LivekH/Mast_control_and_monitor-master/docs/Резюме_работ_v2.md

# Резюме проделанной работы — Mast control v2

Дата актуализации: ноябрь 2025. База: **v1** (джойстики, одна активная ось, реле, ШИМ) без изменения «железной» логики; новое в v2 — **OLED**, **GUI**, **петля 4–20 mA**, **нуль по кнопке**.

## Прошивка

| Компонент | Содержание |
|---|---|
| Скетч | `mast_control_v2/mast_control_v2.ino` |
| Зеркало PIO | `src_V2/mast_control_v2.cpp` |
| Библиотеки | `lib_V2/` — Wire, INA219_WE, U8g2 |
| Сборка Proteus hex | `mast_control_v2.ino.hex` (~976 Hz); `mast_control_v2_PWM244hz.ino.hex` (~244 Hz) |

**Флаг:** `MAST_OLED_PROTEUS` — `1` в симуляции (SSD1306, I2C 100 kHz), `0` на стенде (SSD1309, 400 kHz).

## Давление и INA219

- Петля **4–20 mA** (ИВЭ-50 в разрыве), ток через INA219.
- Пороги: **OPEN** &lt; 3,5 mA, **SHORT** &gt; 20,2 mA, шкала **0…250 bar** от `loop_zero_mA` до 20 mA.
- Нуль по **D12** (удержание **3 с**) или в Proteus — **Virtual Terminal `Z`/`z`**.
- После tare: текущий ток = **0 bar**; ниже нуля на дисплее **не минус**, а **0** (и OPEN при сильном падении).
- Дисплей: усреднение, шаг **2 bar**, зона «малых» значений (`pressure_display_zero_band`).

## OLED GUI

- Давление **000…250 bar**, статусы **PRESSURE SENSOR OPEN/SHORT**, **I2C FAILED**, **ZERO SET** / **TARE FAIL**, **TARE…** при удержании.
- Нижняя строка: разделитель, **3 индикатора осей** (активная — точка + стрелка), **вертикальная шкала ШИМ** с подписями **100** / **0** (шрифт 6×10, центр над/под шкалой).
- Перерисовка по изменению данных (кэш `gui_last_*`).

## Proteus

- Проект: `lib_V2/proteus_V2/`, OLED **SSD1306**, INA219, Nano 16 MHz.
- Защита tare от дребезга D12: повтор только после **отпускания**, cooldown, снятие ZERO SET по таймеру.
- Рекомендация по петле в симуляции: RV **~5,2 kΩ** для плавных шагов тока (см. `proteus_V2/README.md`).

## Документация

| Файл | Назначение |
|---|---|
| `docs/План_версии_v2.md` | План, SSD1309 vs 1306, структура репо |
| `docs/Пины_Arduino_Nano_v2.md` | Распиновка Nano / ATmega328P |
| `README.md` | Обзор репозитория v1/v2 |

## ШИМ D11 (эксперимент CED252)

- Основная v2: **~976 Hz** на D11 (стандарт Arduino).
- Вариант **`mast_control_v2_PWM244hz`**: **~244 Hz** для сравнения с [Walvoil CED252](https://www.walvoil.com/allegati/catalogo/CED252_US.pdf) (**100–150–220 Hz**), без смены пина.
- Описание: `docs/ШИМ_D11_CED252.md`.

## Следующий шаг

- **`#define MAST_OLED_PROTEUS 0`**, прошивка через Arduino IDE / Nano.
- Сборка щита, ИВЭ-50, OLED 2,42″ SSD1309, кнопка **D12**, проверка реле и **D11** на макете.
- Перечень модулей (BOM) — ведётся отдельно.

## Кратко сравнение с v1

| | v1 | v2 |
|---|----|-----|
| Индикация | TM1637 | OLED U8g2 |
| Давление | INA219 + пороги | То же + GUI + нуль D12 |
| Джойстики / реле / D11 | Эталон | Как v1 |
