LivekH/Mast_control_and_monitor-master/docs/Руководство_пользователя_v2.md

# Руководство пользователя — пульт управления мачтой (версия 2)

**Прошивка:** `mast_control_v2`  
**Дисплей:** OLED 128×64, I2C (на приборе — модуль 2,42″)  
**Давление:** датчик по петле **4–20 mA** (ИВЭ-50), измерение тока модулем INA219  

HTML для печати/PDF: **`Руководство_пользователя_v2.html`** (эта же папка) — открыть в браузере, **Ctrl+P**.

Документ для **оператора**: как читать экран и выполнять типовые действия. Технические детали монтажа — в `docs/Пины_Arduino_Nano_v2.md`, описание логики джойстиков (как в v1) — в `docs/Описание_системы_управления.md`.

---

## 1. Назначение

Пульт предназначен для:

- **подъёма и спуска** первой и второй секций мачты (два джойстика);
- **выдвижения и задвижения** «пальцев» (третий джойстик);
- **пропорционального** управления гидравлическим клапаном (мощность по отклонению ручки);
- **индикации давления** в гидросистеме (шкала **0…250 bar**);
- **установки рабочего нуля** датчика давления кнопкой на панели.

Одновременно **активна только одна ось**. Остальные джойстики не управляют клапанами, пока первая не возвращена в **нейтраль** (см. раздел 4).

---

## 2. Меры безопасности

1. Перед работой убедитесь, что **аварийная кнопка «СТОП»** (если установлена на вашей схеме) разрешает питание пульта и МК.
2. **Нейтраль по безопасности** — только когда **разомкнут концевик** на рукоятке джойстика. Положение ручки «примерно по центру» **без** нажатого концевика **не считается** нейтралью.
3. Не удерживайте кнопку **нуль давления** случайно: для срабатывания нужно **намеренное удержание 3 с**.
4. При надписях **OPEN**, **SHORT**, **I2C FAILED** не полагайтесь на цифры давления — устраните неисправность или обратитесь к обслуживающему персоналу.

---

## 3. Включение и заставка

После подачи питания на OLED кратковременно по очереди отображаются:

| Строка 1 | Строка 2 | Смысл |
|---|---|---|
| PRESSURE SENSOR | OPEN | Тест индикации (не означает аварию) |
| PRESSURE SENSOR | SHORT | Тест индикации |
| READY | v2 | Прибор готов к работе |

Затем открывается **основной экран** (раздел 5).

---

## 4. Управление джойстиками (кратко)

У **каждого** джойстика:

| Элемент | Назначение |
|---|---|
| **Концевик нейтрали** | Разомкнут → ось отключена. Замкнут (нажатие рукоятки) → ось может работать. |
| **Потенциометр (ручка)** | Направление и сила: сначала выбирается **реле** (направление), затем при большем отклонении — **ШИМ** пропорционального клапана. |

**Оси:**

| Джойстик | Функция | Реле (направление) |
|---|---|---|
| **1** | Секция мачты **1** | Подъём / спуск |
| **2** | Секция мачты **2** | Подъём / спуск |
| **3** | **«Пальцы»** | Закрыть / открыть |

**Типовая последовательность:**

1. Вернуть используемый джойстик в **нейтраль** (концевик **разомкнут**).
2. Нажать/отклонить рукоятку — концевик **замкнётся**, ось станет **активной** (на дисплее — заполненный кружок, см. §5).
3. Отклонить в нужную сторону: **вверх/закрыть** (стрелка вверх) или **вниз/открыть** (стрелка вниз).
4. По окончании операции — снова **нейтраль** (разомкнуть концевик).

**Смена направления** (вверх ↔ вниз) возможна только после **полного** возврата в нейтраль по концевику.

Подробные пороги АЦП, задержки и блокировка осей — в `docs/Описание_системы_управления.md` (логика совпадает с v1).

---

## 5. Главный экран (GUI)

Экран условно делится на **верх** (давление / сообщения) и **низ** (ось и ШИМ). Нижняя часть рисуется **всегда**, кроме кратких сервисных надписей по центру.

```
┌────────────────────────────────────────┐
│        012 bar          │ 100          │  ← давление или текст ошибки
│                         │ ┃            │     справа — шкала ШИМ
├─────────────────────────┤ ┃            │
│    ○      ○      ●↑     │ ┃▓▓          │  ← три оси: пальцы, мачта2, мачта1
└────────────────────────────────────────┘
                                    0
```

### 5.1. Индикация давления (норма)

- Крупные цифры **000…250** и подпись **bar**.
- Обновление с **шагом 2 bar** (на дисплее 0, 2, 4, …).
- Малые значения после нуля могут отображаться как **000** (зона подавления дрожи у нуля) — это нормально при стабильном низком давлении.
- Шкала привязана к петле **4–20 mA**: по умолчанию **4 mA ≈ 0 bar**, **20 mA ≈ 250 bar**, после **установки нуля** (§6) — от **текущего тока в момент tare**.

**Важно:** если ток в петле **опустится ниже** точки, которую вы зафиксировали как ноль, на дисплее показывается **0 bar**, а **не отрицательное** давление. Сильное падение тока — см. **OPEN** в §7.

### 5.2. Три кружка (слева направо на экране)

| Позиция на экране | Ось | Пульт |
|---|-----|---|
| **Слева** | «Пальцы» (3) | Джойстик 3 |
| **Центр** | Мачта 2 | Джойстик 2 |
| **Справа** | Мачта 1 | Джойстик 1 |

| Вид | Значение |
|-----|---|
| Пустой круг ○ | Ось не активна |
| Залитый круг ● | Ось **активна** |
| Стрелка **вверх** над/под кругом | Движение **вверх** / **закрыть** |
| Стрелка **вниз** | Движение **вниз** / **открыть** |

### 5.3. Шкала справа (ШИМ)

- Вертикальная полоса: снизу **0**, сверху **100** — **относительная мощность** пропорционального клапана для **активной** оси (0…100 %).
- Заполнение растёт при большем отклонении ручки **после** срабатывания направления реле.
- Если ни одна ось не активна — шкала **пустая** (0).

На железе для **пропорционального клапана** может быть залита основная прошивка (~976 Hz ШИМ на D11) или экспериментальная **~244 Hz** — см. `docs/ШИМ_D11_CED252.md`. На поведение джойстика и шкалы ШИМ на OLED это не влияет.

### 5.4. Горизонтальная линия

Разделитель между зоной давления/сообщений и индикаторами осей.

---

## 6. Кнопка «нуль давления» (ZERO)

**Расположение:** пин **D12** на контроллере, на панели — кнопка **«нуль» / «tare»** (замыкание на **GND** при нажатии).

**Назначение:** запомнить **текущий ток** в петле 4–20 mA как **0 bar** на дисплее (калибровка под условия монтажа, без записи в постоянную память — после перезагрузки опора снова **4 mA**, пока не выполните tare снова).

**Действия оператора:**

1. Установите в гидросистеме (или на ИВЭ) давление/ток, которое должно читаться как **0 bar**.
2. Нажмите и **удерживайте** кнопку **не менее 3 с**.
3. На экране появится **TARE…** (идёт удержание), затем **ZERO SET** (~1,2 с).
4. Отпустите кнопку. Должны отобразиться **000 bar** при **неизменном** токе.
5. Повторный сброс — после **отпускания** кнопки и паузы (защита от случайного двойного срабатывания).

| Сообщение | Значение |
|---|---|
| **TARE…** | Кнопка нажата, идёт отсчёт удержания |
| **ZERO SET** | Ноль принят успешно |
| **TARE FAIL** | Не выполнены условия (см. ниже) |

**TARE FAIL** возможен, если:

- нет связи с модулем тока (см. **I2C FAILED**);
- **OPEN** или **SHORT** по петле;
- ток вне допустимого диапазона для захвата нуля (примерно **3,6…19 mA**).

---

## 7. Сообщения об ошибках (верх экрана)

При ошибках **цифры давления скрываются**; нижняя полоса с осями и ШИМ **остаётся**.

| Экран | Причина (для оператора) |
|---|---|
| **PRESSURE SENSOR** / **OPEN** | Слишком малый ток в петле (обрыв, нет сигнала, глубокий провал ниже нормы 4–20 mA). |
| **PRESSURE SENSOR** / **SHORT** | Слишком большой ток (перегруз, КЗ в цепи датчика). |
| **I2C** / **FAILED** | Нет обмена с датчиком тока или дисплеем по шине I2C (проводка, питание модулей). |

**Действия:** прекратить опору на показания давления, проверить подключение ИВЭ-50 и модулей, вызвать специалиста. После восстановления сигнала экран вернётся к **000…250 bar** автоматически.

---

## 8. Типовые ситуации

| Ситуация | Что видно | Что делать |
|---|---|---|
| Старт после включения | READY v2 → главный экран | Работать по §4 |
| Давление растёт | Цифры растут с шагом 2 bar | Норма |
| После ZERO SET | 000 bar при том же режиме | Норма; дальше давление относительно **новой** нулевой точки |
| Другой джойстик «не реагирует» | Его кружок пустой | Сначала нейтраль **активной** оси |
| ШИМ не растёт | Стрелка есть, шкала низкая | Увеличить отклонение ручки (ШИМ включается **после** порога реле) |

---

## 9. Связанные документы

| Документ | Содержание |
|---|---|
| `docs/Пины_Arduino_Nano_v2.md` | Подключение выводов |
| `docs/Резюме_работ_v2.md` | Отличия v2 от v1, техническое резюме |
| `docs/План_версии_v2.md` | План развития |
| `docs/Описание_системы_управления.md` | Подробная логика джойстиков (v1, актуальна для v2) |
| `docs/ШИМ_D11_CED252.md` | Частота ШИМ на клапан (D11), вариант ~244 Hz |

**Перечень аппаратных модулей (BOM)** — по отдельному списку изготовителя прибора.

---

*Версия руководства соответствует прошивке mast_control_v2 (OLED GUI, нуль D12 3 с, шаг давления 2 bar).*
