LivekH/Mast_control_and_monitor-master/docs/ШИМ_D11_CED252.md

# ШИМ на D11 и ориентир Walvoil CED252

Документ для **настройщика и разработчика**. Оператору достаточно знать, что на пульте есть **основная** и **экспериментальная** прошивка — см. `README.md`.

## Источник: паспорт CED252

Официальный каталог (EN/US):

**[Walvoil CED252 — electronic control unit (US PDF)](https://www.walvoil.com/allegati/catalogo/CED252_US.pdf)**

Актуальные копии также на сайте Walvoil: [CED252](https://www.walvoil.it/prodotti/centraline-elettroniche/ced252) (ITA/ENG PDF).

### Что указано в документе (Proportional outputs)

| Параметр | CED252 (по каталогу) |
|---|---|
| Количество | **5** пропорциональных выходов |
| Тип | **HSD PWM** (*High Side Driver*) |
| **Частота ШИМ** | **100–150–220 Hz** (выбираемые/указанные режимы в паспорте) |
| Нагрузка | **до 2 A** на пропорциональный выход |
| Питание блока | **9…16 V** DC |
| ON/OFF выходы | 5 × HSD, до **5 A** |

Отдельно: разъём **Deutsch DRC23-40PA**, IP67, RS232 **9600 8N1**, CAN — это **готовая промышленная централь**, а не Arduino.

### Сравнение с нашим пультом (архитектурно)

| | CED252 | Наш Mast control (Nano) |
|---|---|---|
| Пропорциональный канал | 5 × HSD **12 V**, PWM **100/150/220 Hz** | 1 общий **ШИМ D11** (~976 Hz или ~244 Hz в варианте PWM244) |
| Направление / секции | Несколько силовых выходов HSD | **Реле D2–D7** (низкая сторона / по схеме щита) |
| Аналог «джойстика» | До 11 analog in, 0…5 V / 0…12 V | **A0–A2**, АЦП 0…5 V |
| Разводка | Deutsch 40 pin | Собственная PCB, **D11** на MOSFET |

Полная копия **аппаратуры** CED252 **без переразводки** невозможна: у Walvoil фиксированные **пины OUT_1…OUT_10** на разъёме, у нас — **D11** и реле. Перенос ШИМ на **D9** (Timer1) потребовал бы переделки платы и схемы ключа.

## Зачем вариант ~244 Hz

В каталоге верхняя указанная частота — **220 Hz**. На Nano **Timer2** (пин **D11**) при Fast PWM и **16 MHz** стандартные делители дают:

| Делитель Timer2 | f_pwm (типично) |
|---|---|
| /64 (Arduino по умолчанию) | **~976 Hz** |
| /256 (прошивка `*_PWM244hz`) | **~244 Hz** |

Точные **100 / 150 / 220 Hz** на D11 без смены таймера/режима **не попадают в таблицу делителей** Timer2 (шаг грубый). **244 Hz** — ближайший практический вариант **чуть выше 220 Hz** для полевого эксперимента «ближе к Walvoil, чем 976 Hz».

Формула (Fast PWM, 8 бит):

```text
f_pwm ≈ F_CPU / (N_prescaler × 256)    ; F_CPU = 16 MHz
```

Проверка: **осциллограф** на **D11** (затвор MOSFET / вход клапана по вашей схеме).

## Наши прошивки

| Скетч | ШИМ на D11 |
|---|---|
| `mast_control_v1` / `mast_control_v2` | **~976 Hz** (`analogWrite`) |
| `mast_control_v1_PWM244hz` / `mast_control_v2_PWM244hz` | **~244 Hz** (`analogWriteOutputPowerPwm244`) |

Логика джойстиков, реле, давление, дисплей — **как в основной** v1/v2; меняется только формирование ШИМ на пропорциональный клапан.

### Реализация PWM244 (AVR)

- **D11** = Timer2, **OC2A**.
- После каждого `analogWrite(11, …)` ядро Arduino снова ставит делитель **/64** → в коде сразу вызывается `timer2PwmPrescaler256()`.
- **D3** на том же Timer2 используется как **цифровое реле** — на частоту D11 не влияет.

## Какую прошивку выбрать

| Ситуация | Скетч |
|---|---|
| Макет, Proteus, «как было» | `mast_control_v1` / `v2` |
| Испытание клапана ближе к **100–220 Hz** по духу CED252 | `*_PWM244hz` |
| Итог после стенда | Зафиксировать в паспорте прибора и BOM |

На **~976 Hz** многие клапаны на макете **работают**; вопрос — комфорт, нагрев, динамика. Ориентир Walvoil — **HSD + низкая частота**; наш ключ может быть **low-side 5 V/12 V** — см. вашу схему силового ключа.

## Прошивка

- **v1 PWM244:** `mast_control_v1_PWM244hz/`, библиотеки `lib_V1/`.
- **v2 PWM244:** `mast_control_v2_PWM244hz/`, `lib_V2/`, на железе `MAST_OLED_PROTEUS 0`.

См. также README в папках `*_PWM244hz`, `docs/Пины_Arduino_Nano_v2.md` (D11).
