LivekH/Mast_control_and_monitor-master/docs/Описание_системы_управления.md

# Система управления и мониторинга

**Версия документа:** по прошивке `mast_control_v1/mast_control_v1.ino`  
**Назначение:** управление электромагнитными клапанами мачты и «пальцев» с пульта оператора, индикация давления по петле 4–20 mA, блокировка одновременной работы осей.

Документ можно открыть в браузере (HTML-версия в этой же папке) или в редакторе текста. Схему подключения добавьте отдельным листом.

**Состав основной платы:** плата микроконтроллера, релейный блок, модуль считывания тока (петля 4–20 mA), семисегментный цифровой дисплей (4 разряда).

---

## 1. Общий принцип работы

1. **Пульт оператора** (3 джойстика, нейтральные концевики, питание 5 V) подключается к **основной плате** разъёмом **LD20, 9 pin, male/female** (провода **0,2 mm²**). Внутри пульта и на плате микроконтроллера сигналы джойстиков и МК разведены **разъёмами Dupont**.
2. МК опрашивает **концевики нейтрали** и **аналоговые входы**. **Активна ровно одна ось**, защёлкнутая до её нейтрали; остальные не участвуют в управлении (1 — мачта 1, 2 — мачта 2, 3 — «пальцы»).
3. По выбранной оси МК **замыкает одно из двух реле** направления (подъём/спуск или открыть/закрыть). Направление реле **фиксируется до возврата джойстика в нейтраль по концевику** (рычаг в центре недостаточен — нужен разомкнутый концевик нейтрали).
4. **Пропорциональный канал:** с пина ШИМ (D11) на электромагнитный клапан подаётся сигнал **PWM 0–255** в зависимости от отклонения ручки (после порогов и сглаживания АЦП). Один общий ШИМ на все оси — одновременно работает только активная ось.
5. **Давление:** преобразователь 4–20 mA → **модуль считывания тока** (шина I2C) → расчёт величины на **семисегментный цифровой дисплей**.
6. **Питание пульта:** 12 V → модуль **DC/DC 12/5 V** → линия **+5 V** через **аварийную кнопку «СТОП»** на питание платы микроконтроллера (5 V) и разводку **+5 V / GND** для джойстиков в пульте.

На полевые выходы (клапаны, +12 V, петля 4–20 mA, ШИМ) выведен разъём **LD20, 12 pin, male/female** (провода **0,35 mm²**).

---

## 2. Работа одного джойстика (пример — ось 1, мачта 1)

**Джойстики 2 и 3** подключены и обрабатываются **так же**: тот же концевик нейтрали, те же пороги АЦП, защёлка реле, общий ШИМ и правило «одна активная ось». Отличаются только пины (A1/A2, D9/D10), пары реле (мачта 2 — D4/D5, «пальцы» — D6/D7) и подписи «вверх/вниз» или «закрыть/открыть».

У **одного джойстика** два независимых канала в логику МК:

| Канал | Назначение | Поведение |
|---|---|---|
| **Концевик нейтрали** (кнопка на рукоятке) | Разрешение движения по этой оси | В нейтрали контакт **разомкнут** — ось «спит». При работе контакт **замкнут на GND** — ось может управлять клапанами (если не заблокирована другой активной осью). |
| **Потенциометр** (A0 для оси 1) | Направление и сила (реле + ШИМ) | Выдаёт напряжение, пропорциональное отклонению ручки; МК переводит его в число АЦП (0…1023). |

Ниже — пошагово, что делает прошивка **каждый цикл**, если оператор работает **только джойстиком 1** (остальные в нейтрали).

### 2.1. Состояние «в нейтрали»

1. Концевик разомкнут → на входе D8 логическая **«1»** (подтяжка к +5 V).
2. Флаг **нейтрали оси 1** истинен: **реле мачты 1 не включаются**, **ШИМ = 0**, **защёлка направления сброшена** (можно снова выбрать «вверх» или «вниз»).
3. Потенциометр в этот момент **не определяет** выходы: даже если ручка стоит сбоку, без замкнутого концевика клапаны по оси 1 **не получают команд**.

Это сделано специально: **центр по рукоятке ≠ нейтраль по безопасности** — нейтраль подтверждается только концевиком.

### 2.2. Выход из нейтрали и выбор активной оси

1. Оператор нажимает/отклоняет рукоятку → концевик **замыкается** → на D8 **«0»** (после подавления дребезга ~25 ms).
2. Ось 1 перестаёт быть нейтральной — **фиксируется как активная** до возврата концевика в нейтраль; оси 2 и 3 в этот момент не влияют на выходы даже при случайном нажатии.
3. МК начинает **читать A0**: 4 замера подряд, усреднение, лёгкое сглаживание (фильтр ¾ старое + ¼ новое) — чтобы убрать дрожь проводов.

Пока другой джойстик уже **защёлкан как активный** (например, работает ось 2), ось 1 **не перехватит** управление — её АЦП не обрабатывается, пока ось 2 не вернётся в нейтраль.

### 2.3. Выбор направления реле (защёлка)

Центр шкалы АЦП для всех осей: **510** (нейтраль потенциометра в коде).

| Зона АЦП (ось 1, мачта) | Действие реле |
|---|---|
| **≥ 540** (center + 30) | Защёлка «**вверх**» → реле **D2** (вверх) |
| **≤ 480** (center − 30) | Защёлка «**вниз**» → реле **D3** (вниз) |
| **481…539** | Направление ещё **не выбрано** (мёртвая зона у центра) |

**Важно:** направление реле выбирается **один раз** за один «ход» из нейтрали. Если оператор потянул вверх и защёлка сработала, при откате ручки к центру реле **не переключится** на «вниз» — остаётся «вверх», пока не вернёт **нейтраль концевиком**.

Чтобы **сменить направление** (вверх ↔ вниз): вернуть рукоятку в нейтраль (концевик **разомкнут**), дождаться сброса защёлки, снова выйти из нейтрали и отклонить в другую сторону.

### 2.4. Реле уже есть — включение пропорционального ШИМ

Пороги **ШИМ шире**, чем у реле (чтобы сначала встало направление, потом подросла мощность):

| Направление (защёлка) | Порог старта ШИМ | Шкала |
|---|---|---|
| Вверх | АЦП **≥ 570** | От **570** до упора **758** → ШИМ **51…255** (~20…100 %) |
| Вниз | АЦП **≤ 450** | От **450** до упора **250** → ШИМ **51…255** |

Между порогом реле и порогом ШИМ есть **зазор**: сначала замыкается реле направления (+12 V на нужный соленоид через релейный блок), затем при большем отклонении ручки на общий пропорциональный клапан идёт **ШИМ с D11**.

Если изменение ШИМ меньше **5** единиц — прошивка **не дёргает** выход (deadband), чтобы клапан не «пел».

### 2.5. Что уходит на поле (один цикл выдачи)

Перед каждой выдачей МК **кратко гасит все реле и ШИМ**, затем включает **только активную ось**:

1. **Реле:** одно из двух (вверх D2 или вниз D3) — активный уровень **LOW** (реле замкнуто).
2. **ШИМ:** значение **axis_1_out** на силовой ключ (вывод **D11**, на разъёме LD20 12 pin — **PWM com** по вашей силовой схеме).
3. На выходном разъёме соответственно загораются линии **Valve 1 up** или **Valve 1 down** и общий **+12 V**.

Оси 2 и 3 в этот момент **заблокированы** — их реле и ШИМ не управляются, даже если кто-то случайно задел другую рукоятку.

### 2.6. Возврат в нейтраль

1. Оператор отпускает рукоятку → концевик **размыкается** → снова D8 = «1».
2. Сбрасываются: **защёлка реле**, фильтры АЦП и накопленный ШИМ для оси 1.
3. В цикле **stopAllMotionOutputs** все реле и ШИМ отключены → клапан мачты 1 без питания направления и без пропорциональной составляющей.

После этого можно выбрать **другую ось** (джойстик 2 или 3) — алгоритм тот же.

### 2.7. Краткая «шпаргалка» оператора (ось 1)

```text
Нейтраль (концевик разомкнут)     → всё стоит
Вышел из нейтрали + «вверх»/«вниз» → защёлкнулось реле направления
Дотянул ручку дальше              → растёт ШИМ (плавнее/сильнее)
Вернул концевик в нейтраль        → стоп, сброс; можно другую ось или другое направление
```

---

## 3. Блокировки и защита оператора

| Механизм | Описание |
|---|---|
| **Одна активная ось** | **Защёлка:** как только ось вышла из нейтрали, она остаётся единственной активной до возврата концевика в нейтраль; остальные **не читаются и не управляют** (`lock_*` в отладке). Работа ось 1 → блок 2 и 3; ось 2 → блок 1 и 3; ось 3 → блок 1 и 2. Если все в нейтрали и сразу нажаты несколько джойстиков — выбор 1 → 2 → 3 (только в момент «старта»). |
| **Нейтраль концевика** | В нейтрали концевик **разомкнут** (на МК `INPUT_PULLUP`, лог. 1). При работе концевик **замкнут на GND** (лог. 0). Пока все в нейтрали — реле и ШИМ не активируются. |
| **Защёлка направления реле** | После выхода из нейтрали направление (вверх/вниз, открыть/закрыть) выбирается по АЦП один раз; реле **не переключается** при колебании ручки около центра, пока оператор не вернёт ось в **нейтраль концевиком**. |
| **Реле / ШИМ по порогам** | Универсальный профиль: center **510**; реле **≤480 / ≥540** АЦП; ШИМ **≤450 / ≥570** АЦП; сглаживание АЦП (4 выборки + фильтр) и deadband ШИМ **±5**. |
| **Аварийный стоп (аппаратный)** | Разрыв **+5 V** на МК и пульт до кнопки СТОП — при нажатии питание контроллера и джойстиков отключается (описывается монтажом, не прошивкой). |
| **Петля 4–20 mA** | Ниже **3,5 mA** — режим обрыва **`-OC-`**. Выше **20,2 mA** — **`-SC-`**. У нуля шкалы ток **&lt; 4,15 mA** считается **0** на индикаторе (шум измерения). |
| **I2C / модуль тока** | Таймаут шины, восстановление; при длительном сбое (**5 с**) — **`I2c-`** на дисплее. |
| **Реле** | Активный уровень **LOW** (реле замкнуто). Перед каждым циклом выходов — кратковременное **отключение всех реле и ШИМ**, затем включение только активной оси (исключение коротких сквозных состояний). |

---

## 4. Пульт оператора — разъём LD20 9 pin (0,2 mm²)

Связь пульт ↔ основная плата: **LD20, 9 контактов, male/female**. Подключение джойстиков и выводов на **плату микроконтроллера** внутри узла — **Dupont**.

| № пина | Назначение | Цвет провода | Подключение на плате МК |
|---|---|---|---|
| 1 | **VCC +5 V in** (после СТОП) | Красный | +5 V платы микроконтроллера (питание МК и логики) |
| 2 | **+5 V out** (на джойстики пульта) | Оранжевый | Шина +5 V для потенциометров джойстиков |
| 3 | **Button Joy1** (концевик нейтрали 1) | Белый | **D8**, замыкание на **GND** при работе |
| 4 | **Vout Joy1** (потенциометр ось 1) | Зелёный | **A0** |
| 5 | **GND** | (общий) | **GND** платы микроконтроллера |
| 6 | **Button Joy2** | Серый | **D9** → GND |
| 7 | **Vout Joy2** | Жёлтый | **A1** |
| 8 | **Button Joy3** | Фиолетовый | **D10** → GND |
| 9 | **Vout Joy3** | Синий | **A2** |

**Логика концевика:** нейтраль — контакт **разомкнут** (pull-up → «1»); из нейтрали — **замкнут на GND** («0»).

**Оси на клапаны (прошивка):**

| Ось | Джойстик | Реле направления | ШИМ |
|-----|---|---|-----|
| 1 | Joy1 | Мачта 1 вверх / вниз | Общий D11 |
| 2 | Joy2 | Мачта 2 вверх / вниз | D11 |
| 3 | Joy3 | «Пальцы»: закрыть / открыть | D11 |

Ось 3: отклонение АЦП «+» (≥ порога) — **закрыть** (D6); «−» — **открыть** (D7).

---

## 5. Основная плата — сопоставление МК и релейного модуля

### 5.1. Выходы платы микроконтроллера (прошивка)

| Функция | Пин МК |
|---|---|
| Реле мачта 1 вверх | **D2** |
| Реле мачта 1 вниз | **D3** |
| Реле мачта 2 вверх | **D4** |
| Реле мачта 2 вниз | **D5** |
| Реле «пальцы» закрыть | **D6** |
| Реле «пальцы» открыть | **D7** |
| ШИМ пропорциональный клапан | **D11** |
| Дисплей, такт | **D12** |
| Дисплей, данные | **D13** |
| Модуль тока SDA / SCL | **A4 / A5** |

Цепи от выводов МК к релейному модулю, дисплею и модулю тока — **Dupont** (по схеме монтажа).

### 5.2. Выходной разъём LD20 12 pin (0,35 mm²) — полевая коммутация +12 V

**LD20, 12 контактов, male/female.** Релейный блок коммутирует **+12 V** на обмотки соленоидных клапанов. Номинал источника: **12 V, до 5 A** (220 V → 12 V).

| № пина | Назначение | Цвет | Соответствие клапану / сигналу |
|---|---|---|---|
| 1 | **Valve 3 up** | Оранжевый | Клапан 3 «вверх» / закрыть (реле ось 3, D6 при логике прошивки) |
| 2 | **Valve 3 down** | Жёлтый | Клапан 3 «вниз» / открыть (D7) |
| 3 | **Valve 2 up** | Синий | Мачта 2 вверх (D4) |
| 4 | **VCC +12 V** | Красный | Питание +12 V на реле / клапаны |
| 5 | **Valve 2 down** | Белый | Мачта 2 вниз (D5) |
| 6 | **Valve 1 up** | Серый | Мачта 1 вверх (D2) |
| 7 | **GND** | Чёрный | Общий минус |
| 8 | **GND** | Чёрный | Общий минус (дубль) |
| 9 | **Valve 1 down** | Фиолетовый | Мачта 1 вниз (D3) |
| 10 | **D+** | Зелёный | Петля 4–20 mA, «плюс» / питание датчика (через модуль считывания тока) |
| 11 | **D−** | Коричневый | Петля 4–20 mA, «минус» / возврат |
| 12 | **PWM com** | (по схеме) | Общий/коммутация силового ключа ШИМ (D11) — по вашей силовой части |

*Точная привязка «pin 12» к схеме мосфета уточняется монтажной схемой; логика ШИМ — с **D11**.*

### 5.3. Пропорциональное управление

- Сигнал **PWM** с **D11** задаёт мощность на **один** пропорциональный электромагнитный клапан (или общую нагрузку через силовой ключ).
- Шкала: минимум ~**20 %** сразу за порогом ШИМ, максимум **255** у физического упора ручки (АЦП **250** вниз, **758** вверх — настройки прошивки).
- При неактивной оси ШИМ в состоянии **выкл.** (на плате — `HIGH` на D11 по принятой логике).

---

## 6. Датчик давления 4–20 mA и дисплей

### 6.1. Измерение

- Ток измеряется **модулем считывания тока** (шина I2C, адрес **0x40**).
- Опрос — **каждый цикл** программы; на дисплей выводится **среднее** за **100 ms** (сглаживание и deadband **4** единицы).
- Шкала (калибровочная): **4 mA → 0**, **20 mA → 250** (условные единицы на индикаторе, подстройка `map` при необходимости).

### 6.2. Сообщения на семисегментном дисплее (4 символа, выравнивание вправо)

| Индикация | Условие |
|---|---|
| **`-OC-`** | Обрыв петли (ток &lt; 3,5 mA, I2C в норме) |
| **`-SC-`** | Перегруз / КЗ петли (ток &gt; 20,2 mA) |
| **`I2c-`** | Нет связи с модулем считывания тока дольше 5 с |
| **Цифры 0…9999** | Нормальный режим (условно давление/бар) |
| **`-OC-` → `-SC-` → `donE`** | Краткий **самотест** при включении (~0,5+0,5+2 с), затем переход на цифры |

При выходе из аварии на дисплей снова переключаются **цифры**.

---

## 7. Последовательность работы для оператора

1. Включить питание (12 V → DC/DC → 5 V, СТОП отпущена).
2. Дождаться окончания заставки **`donE`**, затем на дисплее — давление (или аварийный код).
3. Все джойстики в **нейтрали** (концевики разомкнуты).
4. Вывести **одну** ось из нейтрали (нажать/отклонить до срабатывания концевика).
5. Отклонить ручку: сначала срабатывает **реле направления**, при дальнейшем ходе — растёт **ШИМ**.
6. Для смены направления или другой секции — вернуть ручку в **нейтраль концевиком**, затем активировать другую ось.

---

## 8. Настройки прошивки (для сервиса)

В начале файла `mast_control_v1.ino` блок **«ПЕРЕМЕННЫЕ И НАСТРОЙКИ»**:

- **`joyProf1/2/3`** — пороги АЦП джойстиков.
- **`joy_adc_down_travel` / `joy_adc_up_travel`** — упоры ШИМ (**250** / **758**).
- **`ina_*`, `display_*`** — давление и дисплей.
- **`joy_adc_avg_samples`, `joy_pwm_change_deadband`** — сглаживание ШИМ.
- **`serial_debug_enabled`** — **false** в эксплуатации; **true** только для калибровки с ПК.

Дублированная копия для сборки PlatformIO: `src/mast_control_v1.cpp`.

---

## 9. Примечания по монтажу

- Общая **GND** между платой микроконтроллера, релейным блоком, 12 V, петлёй 4–20 mA и пультом обязательна.
- Разъёмы **LD20** — на границе «пульт / плата» (9 pin) и «плата / полевые клапаны и петля» (12 pin).
- **Dupont** — джойстики в пульте, разводка на плате микроконтроллера, подключения к релейному модулю, дисплею и модулю тока; длина и качество обжима влияют на стабильность АЦП (учтены фильтры в прошивке).
- Перепутанные «вверх/вниз» на одной секции — меняются местами константы пинов D2/D3 (или физические провода на разъёме).

---

*Разработчики исходного проекта: Олег «Salty NUggeTZ» Величко, Игорь «Terrano». Описание по итогам доводки прошивки и монтажа пульта.*
