LivekH/Mast_control_and_monitor-master/docs/shematic capture.jpg

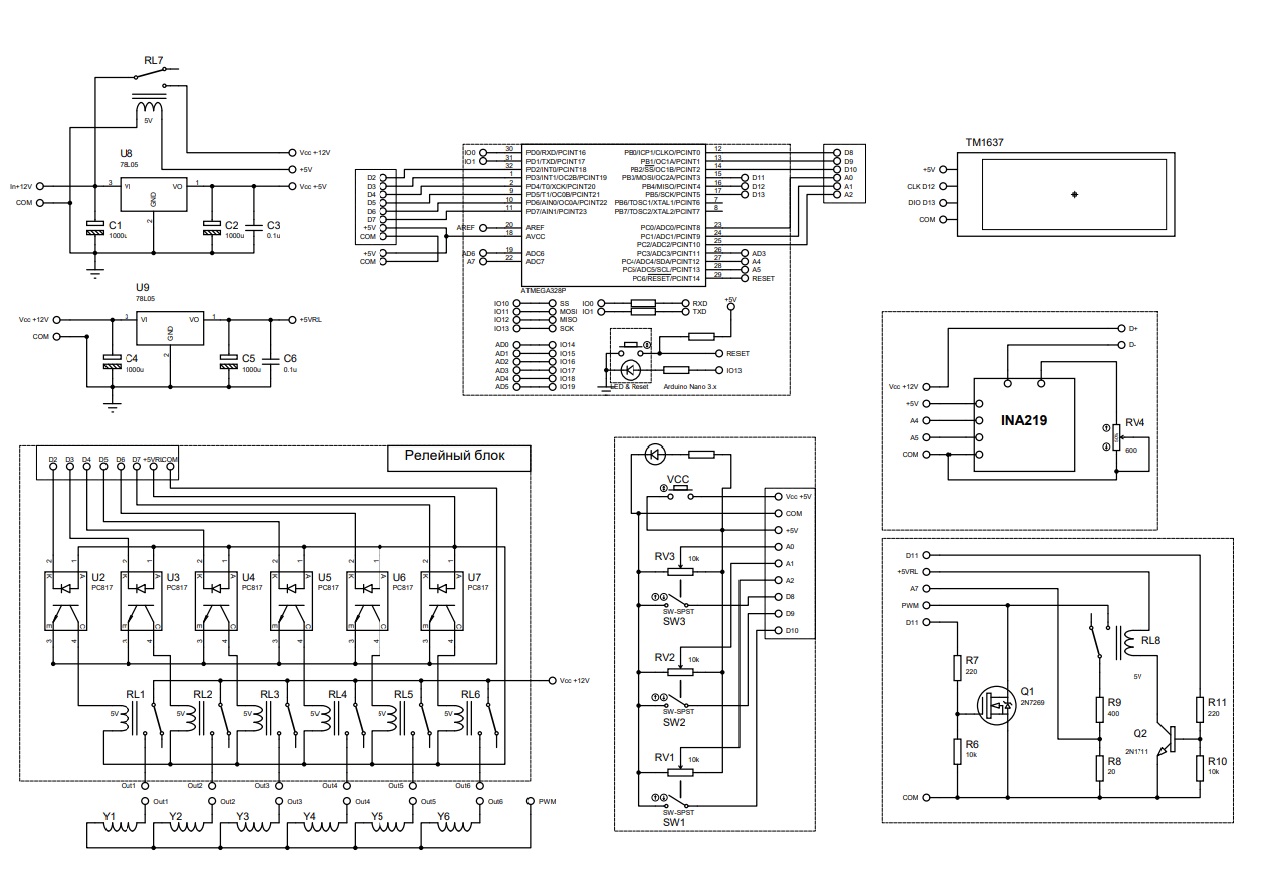
docs/shematic capture.jpg
