LivekH/Mast_control_and_monitor-master/docs/shematic capture.pdf

U8

C1

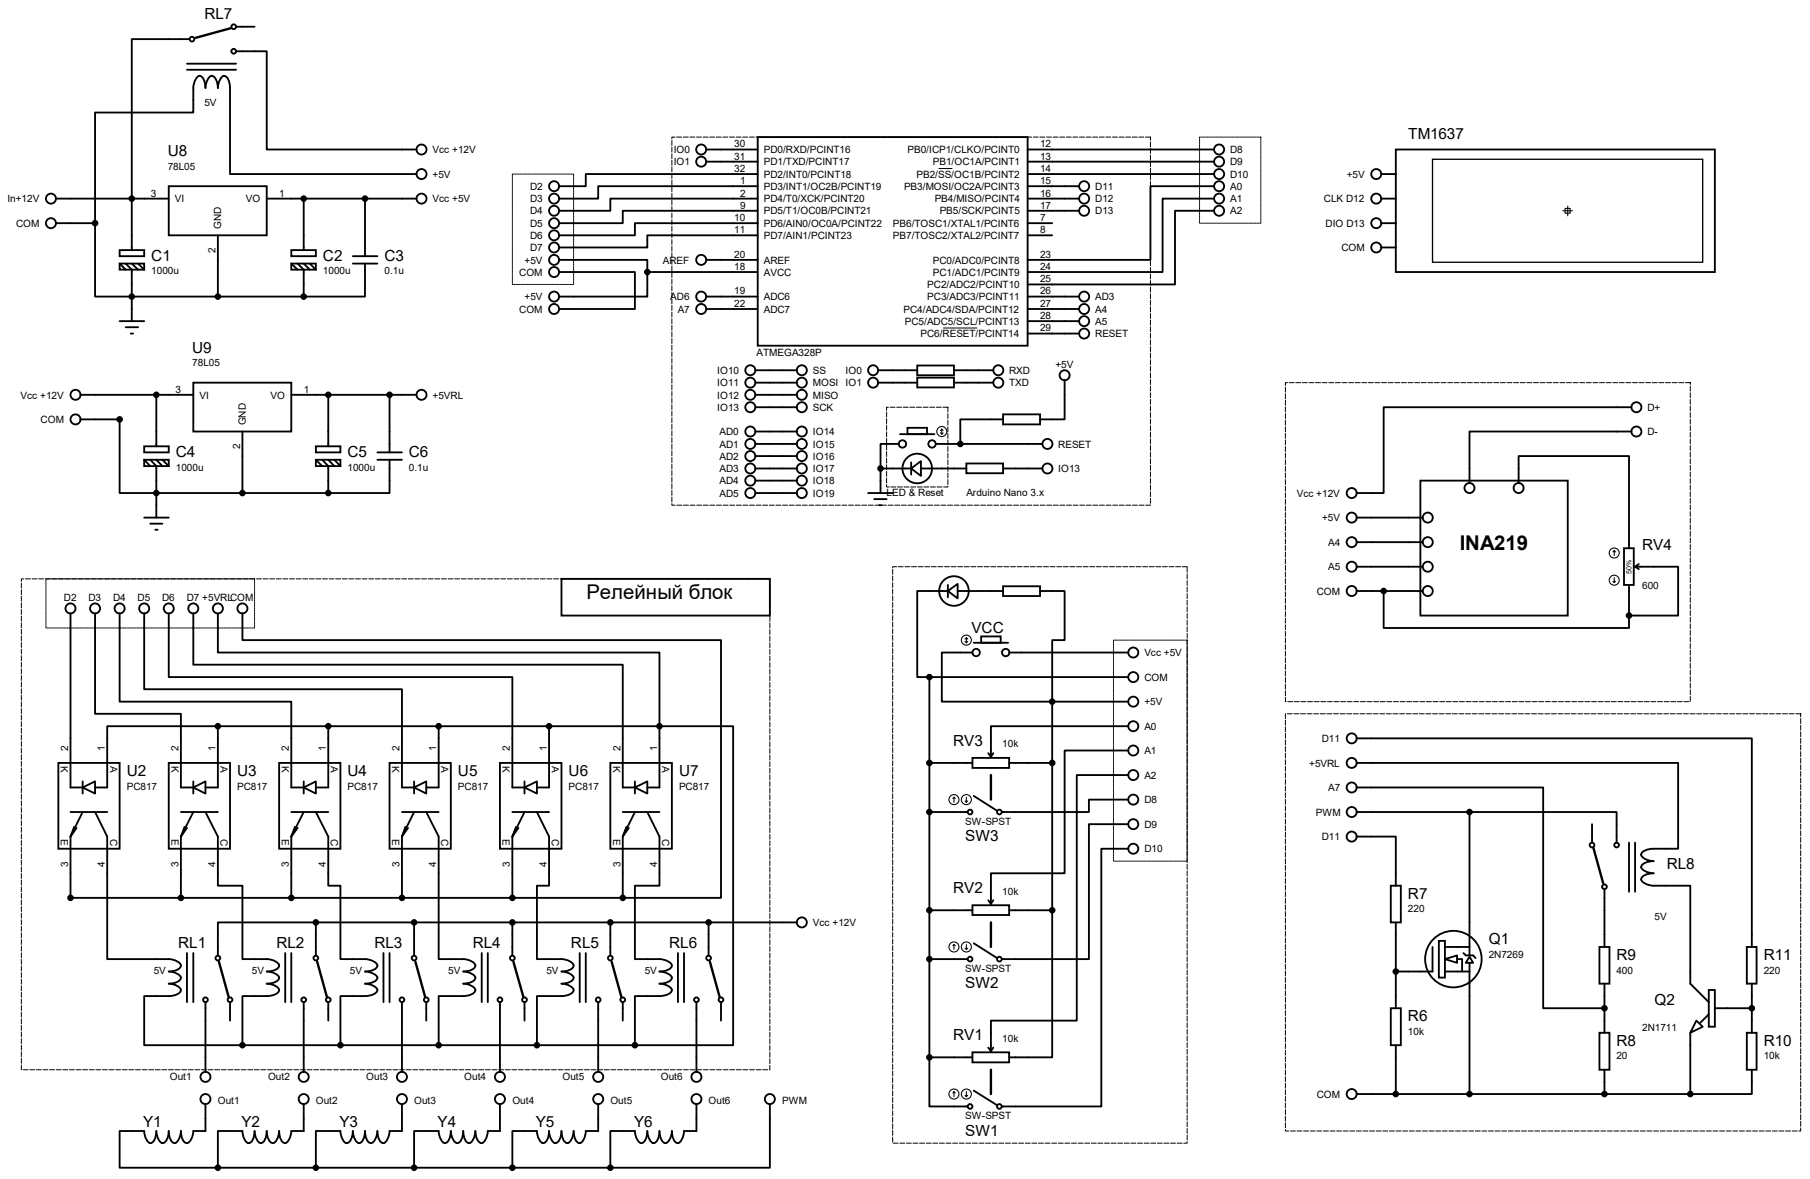
[picture p5: page 1]
