LivekH/Mast_control_and_monitor-master/(list of files, drawings)

Other design files:
lib_V1/proteus_V1/Mast_control_and_monitor-master_scheme V3_Dwin.pdsprj
lib_V2/proteus_V2/Mast_control_and_monitor-master_scheme V2.pdsprj
