LivekH/Mast_control_and_monitor-master/(commit log)

2026-11-13 add new version output PWM 244hz
    [Mast_control_and_monitor-master_scheme V2.pdsprj]
2026-11-13 Timer2 via OCR2A
    Rebuilt, Timer2 via OCR2A (without analogWrite in each loop)
    [Mast_control_and_monitor-master_scheme V2.pdsprj]
